arturo182/bbq10kbd_breakout/readme.md

# Blackberry Q10 Keyboard breakout board

This is a very simple board breaking out the Q10 keyboard connector, the Hirose BM14B(0.8)-24DS-0.4V(53), but it is enough to read all the keys, as well as the MIC pin and provide backlight.

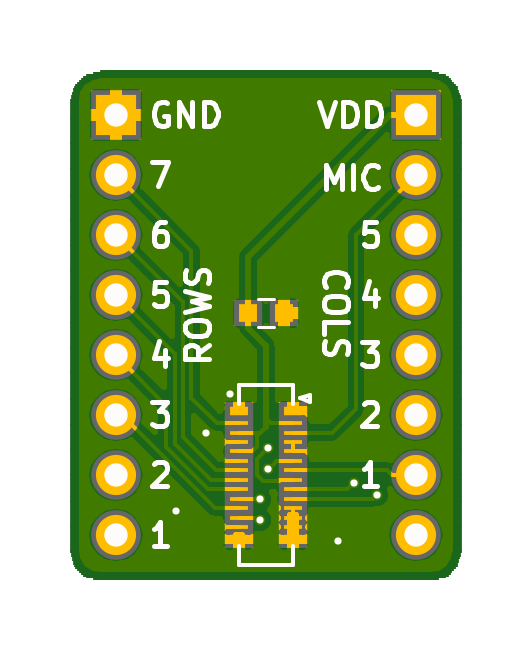
[picture p1: img/front.png]
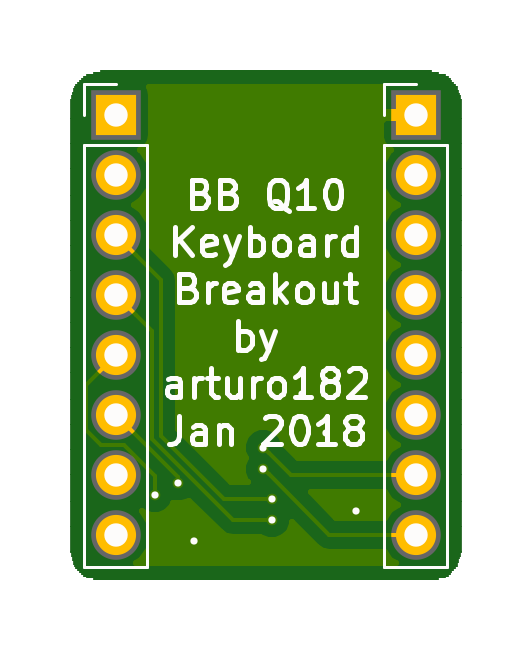
[picture p2: img/back.png]
 

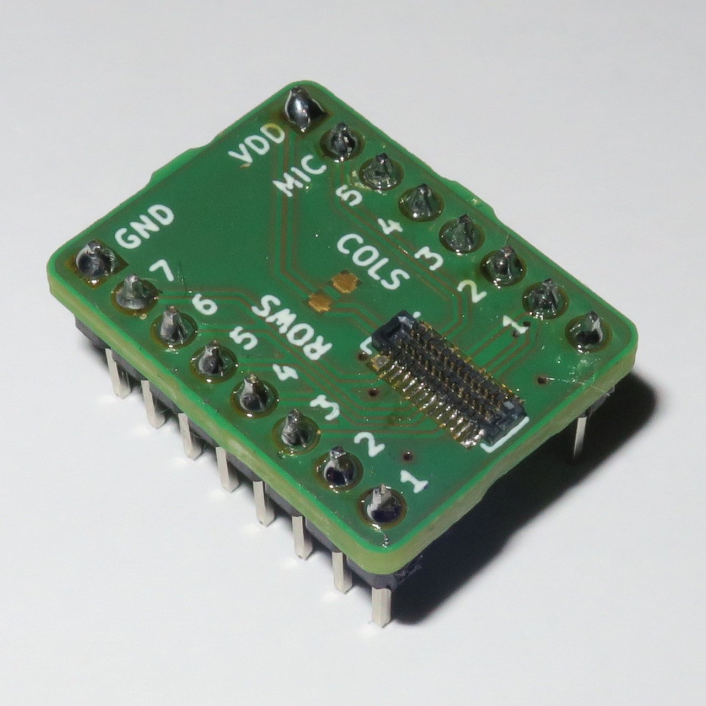
[picture p3: img/photo.jpg]
 

For more details about the Q10 keyboard see:

https://github.com/arturo182/BBQ10KBD
