arturo182/bbq10kbd_breakout/1-click-bom.csv

References | Qty | Description | Manufacturer | MPN | Manufacturer | MPN | Digikey | Mouser | RS | Newark | Farnell
J2, J1 | 2 | pin header, 1x08, 2.54mm pitch, single row | Molex | 901-20-0128 | Molex | 90120-0128 | WM8078-ND | 538901200128 | 6705041P |  | 3049365
C1 | 1 | Capacitor SMD 0603 100nF | Yageo | CC0603KRX7R9BB104 | Murata | GRM188R71H104KA93D | 311-1344-1-ND | 603CC603KRX7R9BB104 | 6242480P |  | 1362556
U1 | 1 | BM14B(0.8)-24DS-0.4V(53) | Hirose | BM14B(0.8)-24DS-0.4V(53) |  |  | H122178DKR-ND | 798BM14B0824DS04V53 | 1620941 |  | 2724957
