arturo182/bbq10kbd_breakout/schematic.pdf

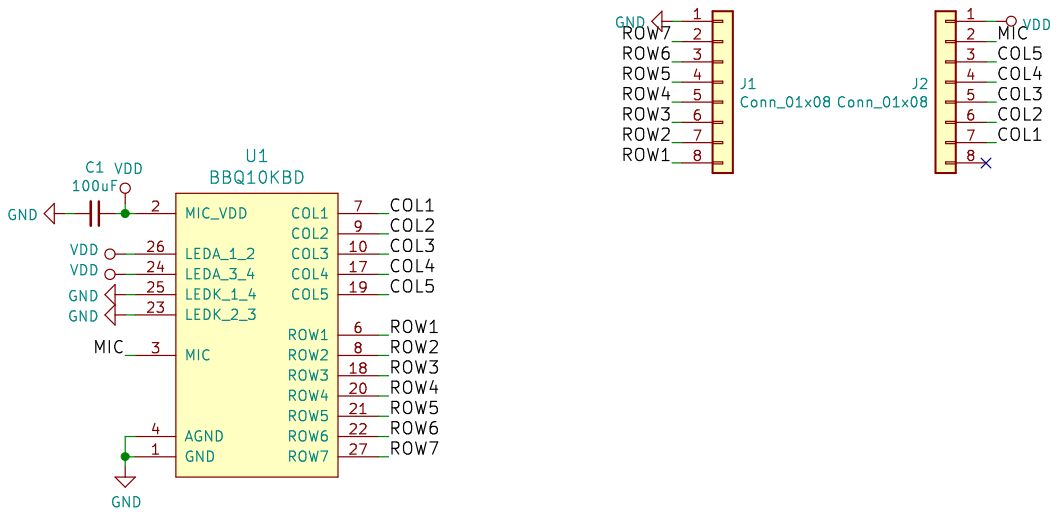
[picture p4: page 1]
