arturo182/bbq10kbd_breakout/(threads)

Thread 1 (2018-05-08):

Board and connector

Fnux, 2018-05-08:
Hello,

I have some trouble finding your email adress so this issue will do. I have a few questions:

  * What connector do you use on the board ?
  * Do you have any good plan or advise to obtain/print the board ? That's something I never did.

Thanks!

arturo182, 2018-05-08:
You can find more info about the connector here: https://github.com/arturo182/BBQ10KBD

For ordering PCBs I'd recommend https://oshpark.com if you are in US and https://aisler.net if you are in Europe.

Fnux, 2018-05-08:
That's perfect. Thanks!

Closed 2018-05-08.
