arturo182/bbq10kbd_breakout/(commit log)

2018-01-19 Fix via problem and add back silk
    [bbq10breakout.kicad_pcb]
2018-01-20 Added photos, schematic and readme
2018-03-07 Added gerbers and updated the files to latest nightly
    [bbq10breakout-B.Cu.gbl, bbq10breakout-B.Mask.gbs, bbq10breakout-B.SilkS.gbo, bbq10breakout-Edge.Cuts.gm1, bbq10breakout-F.Cu.gtl, bbq10breakout-F.Mask.gts, bbq10breakout-F.SilkS.gto, bbq10breakout.drl]
2019-10-14 Make compatible with kitspace.org
    [1-click-bom.csv]
2019-10-14 Correct C1, add J1,J2 SKUs to 1-click-bom
    [1-click-bom.csv]
